michalprusa/DIP/Text/0-0-0-main.tex

% -*- Mode:TeX -*-

%% IMPORTANT: The official thesis specifications are available at:
%%            http://libraries.mit.edu/archives/thesis-specs/
%%
%%            Please verify your thesis' formatting and copyright
%%            assignment before submission.  If you notice any
%%            discrepancies between these templates and the 
%%            MIT Libraries' specs, please let us know
%%            by e-mailing thesis@mit.edu

%% The documentclass options along with the pagestyle can be used to generate
%% a technical report, a draft copy, or a regular thesis.  You may need to
%% re-specify the pagestyle after you \include  cover.tex.  For more
%% information, see the first few lines of mitthesis.cls. 

%\documentclass[12pt,vi,twoside]{mitthesis}
%%
%%  If you want your thesis copyright to you instead of MIT, use the
%%  ``vi'' option, as above.
%%
%\documentclass[12pt,twoside,leftblank]{mitthesis}
%%
%% If you want blank pages before new chapters to be labelled ``This
%% Page Intentionally Left Blank'', use the ``leftblank'' option, as
%% above. 

\documentclass[11pt,oneside]{mitthesis}
\usepackage{lgrind}
\usepackage{titlesec}
\usepackage{pgfplots}
\usepackage{listings}
\usepackage{pdfpages}
\lstset{language=C}
\usepackage{nomencl}
\usepackage{siunitx}

\usepackage{float}

\usepackage[europeanresistors]{circuitikz}

\usepackage{tikz}
%% These have been added at the request of the MIT Libraries, because
%% some PDF conversions mess up the l50\,$\mu$migatures.  -LB, 1/22/2014
\usepackage{cmap}
\usepackage[T1]{fontenc}
\usepackage[utf8]{inputenc}
\pgfplotsset{every axis legend/.append style={
at={(1.1,0.2)},
anchor=south west}} 

\pagestyle{plain}
\titlespacing\section{0pt}{12pt plus 4pt minus 2pt}{12pt plus 4pt minus 8pt}
\renewcommand{\chaptername}{Kapitola}
\renewcommand{\figurename}{Obrázek}
\renewcommand{\tablename}{Tabulka}
\renewcommand{\contentsname}{Obsah}
\renewcommand{\contentsname}{Obsah}
\renewcommand{\listtablename}{Tabulky}
\renewcommand{\listfigurename}{Obrázky}
\renewcommand\bibname{Reference}

%\addtocontents{toc}{\protect\thispagestyle{empty}}
%\addtocontents{lof}{\protect\thispagestyle{empty}}

\newcommand{\itab}[1]{\hspace{0em}\rlap{#1}}
\newcommand{\tab}[1]{\hspace{.2\textwidth}\rlap{#1}}

\newcommand\uv[1]{\quotedblbase #1\textquotedblleft}
\usepgfplotslibrary{polar}
\makenomenclature

\begin{document}

\include{cover}

\pagestyle{plain}
\include{contents}

\setcounter{page}{1}
\include{0-Introduction}
\include{1-Theoretical}
\include{2-Design}
\include{3-Realization}
\include{4-Conclusion}

\include{80-bibl}
\include{0-nome}
%\include{99-add-safety}
\include{99-CD}

\thispagestyle{empty}
\null\newpage

%%\include{biblio}
\end{document}
