michalprusa/DIP/Text/80-bibl.tex

\begin{thebibliography}{9}

\bibitem{ModernLens}
  John Thornton,
  Kao-Cheng Huang,
  MODERN LENS ANTENNAS FOR COMMUNICATIONS ENGINEERING,
  Wiley,
  IEEE PRESS,
  2013.

\bibitem{Dolecek}
  Josef Doleček,
  Fillamentum,
  Parzlich s.r.o.,
  Konzultace na téma výroby filamentů,
  2016.

\bibitem{ConstantineTheory}
  Constantine A. Balanis,
  Antenna theory analysis and design,
  Wiley,
  4th edition,
  2016.

\bibitem{3Dhubs}
  https://www.3dhubs.com/trends,
  2017.

\bibitem{EMIdata}
  https://www.gme.cz/data/attachments/dsh.749-035.1.pdf,
  Datasheet EMI 35 spray,
  2007.

\bibitem{Electroforming}
  http://www.electroforming.cz/cs/technologie,
  Elektroforming, popis technologie 
  2017.

\end{thebibliography}

\newpage

\listoffigures
