michalprusa/DIP/Rozsahy vlnovych delek a kmitoctu.pdf

# Rozsahy kmitočtů a vlnových délek pro vlnovody

R100

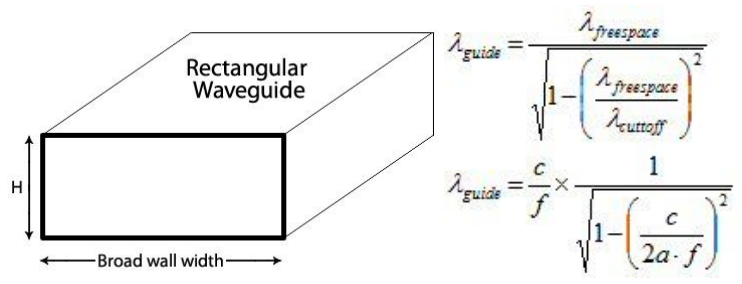
[picture p1: figure]

Dimensions WxH : 22.86 x 10.16 mm

- | Min | Mid | Max
f/GHz | 8.2 | 10.3 | 12.4
ƛ/mm | 60.89 | 37.74 | 28.49

R70

Dimensions WxH : 34.85 x 15.8 mm

- | Min | Mid | Max
f/GHz | 5.85 | 7.025 | 8.2
ƛ/mm | 75.61 | 53.97 | 42.94

R48

Dimensions WxH : 47.55 x 22.15 mm

- | Min | Mid | Max
f/GHz | 3.95 | 4.9 | 5.85
ƛ/mm | 126 | 79.92 | 60.83

//https://www.microwaves101.com/encyclopedias/waveguide-mathematics#guide
