michalprusa/DIP/Text/0-nome.tex

% $Log: abstract.tex,v $
% Revision 1.1  93/05/14  14:56:25  starflt
% Initial revision
% 
% Revision 1.1  90/05/04  10:41:01  lwvanels
% Initial revision
% 
%
%% The text of your abstract and nothing else (other than comments) goes here.
%% It will be single-spaced and the rest of the text that is supposed to go on
%% the abstract page will be generated by the abstractpage environment.  This
%% file should be \input (not \include 'd) from cover.tex.
\thispagestyle{empty}
\chapter*{Seznam použitých symbolů a zkratek}
\thispagestyle{empty}
\itab{3D} \tab{} \tab{3-rozměrné}\\*
\itab{LED} \tab{} \tab{Světlo emitující dioda}\\*
\itab{CD} \tab{} \tab{Kompaktní disk}\\*
\itab{VNA} \tab{} \tab{Vector network analyzer}\\*
\itab{ABS} \tab{} \tab{Acrylonitrile butadiene styrene}\\*
\itab{PLA} \tab{} \tab{Polylactic acid}\\*
\itab{PET} \tab{} \tab{Polyethylene terephthalate}\\*
\itab{D.U.T.} \tab{} \tab{Device under test}\\*
