michalprusa/DIP/Text/1-Theoretical.tex

%% This is an example first chapter.  You should put chapter/appendix that you
%% write into a separate file, and add a line \include{yourfilename} to
%% main.tex, where `yourfilename.tex' is the name of the chapter/appendix file.
%% You can process specific files by typing their names in at the 
%% \files=
%% prompt when you run the file main.tex through LaTeX.
\chapter{Teoretický rozbor}
Před vlastním návrhem a realizací je nezbytně nutné být seznámen alespoň se základní teorií použitých technologií a postupů. Bez této znalosti by se jednalo pouze o útržky textu a nebylo by možno zacházet do řešení komplexnější problematiky a kladení možných dalších témat pro následující výzkum a posun technologie.

\section{3D tisk a materiály}
3D tisk je na rozdíl od jiných technologií aditivní proces. Jedná se tedy o postupné přidávání základního materiálu v diskrétních krocích (vrstvách).
Technologií existuje několik a s postupným rozšiřováním možností aplikace jich stále přibývá. Pro řešení této práce byla vybrána technologie FDM vzhledem k jejímu masovému rozšíření, dostupnosti a nízkých nákladů. 

\subsection{Princip technologie FDM}
Fused deposition modeling, zkráceně FDM, případně FFF (Fused Filament Fabrication) je technologie 3D tisku využívající možnost opakovatelného přechodu mezi skupenstvími působením energie ve formě tepla termoplastických polymerních materiálů. Základní materiál ve formě filamentu (drátu) definovaného průměru, zpravidla 1.75\,mm, nebo 2.85\,mm, je vtlačován do předehřáte trysky silou $F$. Pokud teplota horké zóny trysky převyšuje teplotu skelného přechodu vtlačovaného materiálu dojde k dramatickému oslabení mezimolekulárních sil a vzniku viskózní kapaliny. Jelikož je průměr trysky velmi blízký průměru vtlačovaného filamentu, s výjímkou jejího hrdla které je násobně menší, zpravidla 0.4\,mm, jediná možnost jak uvolnit vnitřní tlak je vytlačení kapaliny hrdlem. Jakmile teplota vytlačené kapaliny klesne pod teplotu skelného přechodu dojde k obnovení mezimolekulárních sil a materiál je opět pevnou látkou. Tento jev je obecně znám pod názvem extruze.
Toto nám však nestačí pro vytvoření trojrozměrného objektu dle zadání. Je tedy třeba extrudér osadit na zařízení zajišťující pohyb v trojrozměrném prostoru.
Proces tisku pak probíhá pohybem extrudéru po předem definovaných trasách, zpravidla vždy v jedné vrstvě, a vytlačováním materiálu dle potřeby. Celý proces se poté opakuje dokud není dokončen zadaný objekt.
\begin{figure}[!htbp!]
\begin{center}
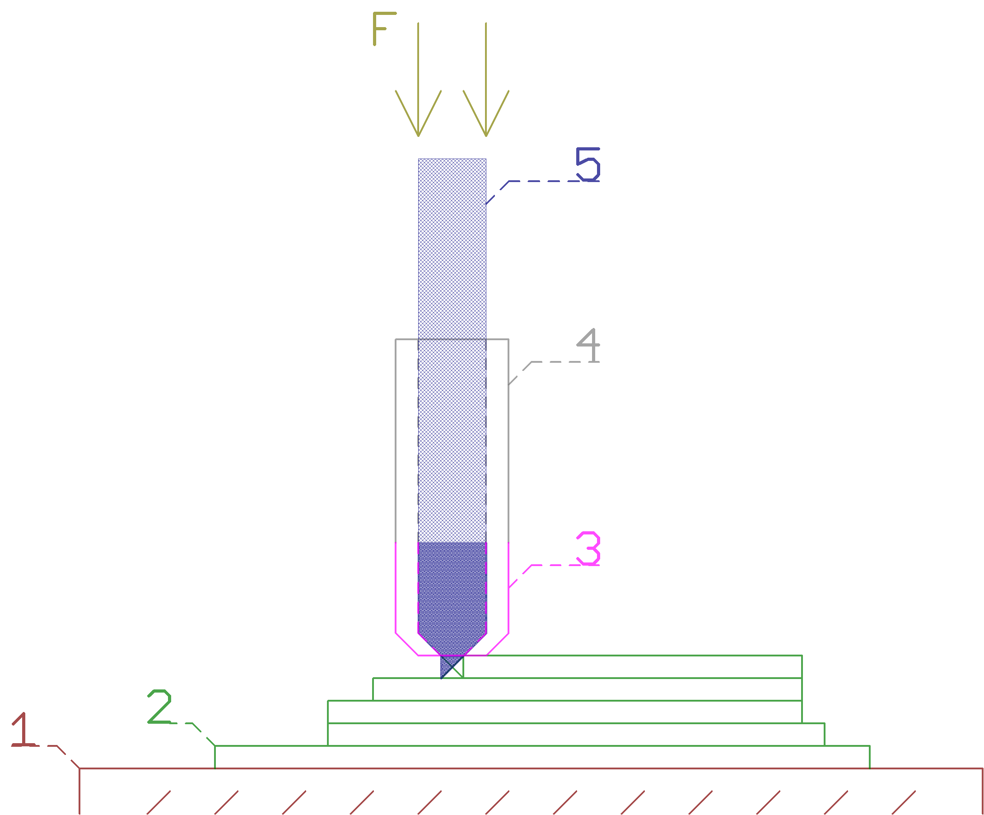
[picture p9: Text/pics/fdm.png]

\caption{Princip technologie FDM. 1 - Tisková podložka, 2 - Již hotové vrstvy výsledného objektu, 3 - Horká zóna trysky, 4 - Tryska, 5 - Filament, F - Vtlačovací síla}
\end{center}
\end{figure}

\subsection{Vlastnosti technologie}
3D tisk, podobně jako jiné technologie má specifické vlastnosti, které ovlivňují charakter výsledného produktu. Ovlivněných vlastností je velmi mnoho, pro naši aplikaci se zaměříme na dielektrické (chceme vědět jaké bude mít výsledný produkt dielektrické vlastnosti, abychom ho byly schopni popsat, navrhovat a simulovat) a mechanické (produkt musí být možno pevně a stabilně ukotvit na pozici, a musí do něj být možno navázat elektromagnetickou vlnu známým způsobem). Je však nutno brát v potaz, že má i celou řadu vlastností, kterých lze využít pro vytvoření složitých struktur, které by nebylo možné jinými technologiemi jednoduše realizovat, například vnitřní uzavřené struktury. Některé z nich jsou zatím pro dostatečně přesné aproximace dosažitelné v reálném časovém horizontu zcela náhodné, jiné zase přímo ovlivňují námi velmi žádané parametry a můžeme je takto řídit.

\subsubsection{Vrstvy}
Pokud budeme uvažovat ideální podmínky (absolutně čisté prostředí bez kontaminace nechtěnými látkami, ideální filament, rovnoměrnou kontrolovanou distribuci tepla, atd...) stále je objekt tvořen z vrstev. Jelikož vždy vrstva, na které se aktuálně nanáší, je dokonce pod teplotou skelného přechodu, pro odstranění deformace vlivem sil jako gravitace, či tepelné roztažnosti, nedojde k dokonalému spojení polymerních řetězců mezi vrstvami. Při laminaci vrstev může také dojít ke kontaminaci produktu, jako například prachovými částicemi či vzduchovými kapsami. Toto se však dá zanedbat jelikož lze snadno stabilizovat okolní prostředí a minimalizovat vliv. 
Hlavní ovlivněné vlastnosti, pro naši aplikaci podstatné, jsou mechanické. Vždy je v ose vrstev rozložení meze plasticity neuniformní, dochází tedy k plastické deformaci významně v těchto oblastech, což někdy může být problém z důvodu nutnosti splnění možnosti upevnění a realizovatelnosti produktu.
Z dielektrického hlediska tedy nebude ani relativní permitivita uniformně rozložená v jedné ose, vznikne tedy periodická struktura. Tento vliv by bylo možné omezit buďto zvýšením diskretizačního kroku, tedy omezením počtu rozhraní, což může v jistých případech ovlivňovat vlastnosti celé struktury vzhledem růstu kvantizačního šumu, nebo naopak snížením kroku kdy již bude úroveň šumu blízká nule, což se bohužel negativně projeví na době tisku, to však v některých případech není problém. Výzkum popisu tohoto chování je však předmětem dalším.

\subsubsection{Vnitřní struktury}
Vlivem principu vrstvení je možno vytvářet vnitřní struktury definovaných tvarů, dokonce i selektivně, a takto velmi silně ovlivňovat pro nás důležité parametry.
Mechanické vlastnosti tímto lze selektivně měnit, například zpevněním montážních otvorů v technologickém okolí, což v našem případě není první v pořadí.
Dielektrické vlastnosti jsou tímto však velmi ovlivněny. Technologií je totiž možno vytvářet prakticky jakékoliv struktury uvnitř produktu ve zvolených místech, tedy například vytisknout Luneburgovu či Maxwell fish-eye čočku. Je však ale nutno provést výzkum na toto téma dostatečné podrobný výzkum, jedná se totiž o skokové změny vlastností. Tyto změny poté vytváří rozhraní, kde dochází odrazům, které zatím modelovat a popsat je velmi komplexní úlohou.

\begin{figure}[!htbp]
\begin{center}
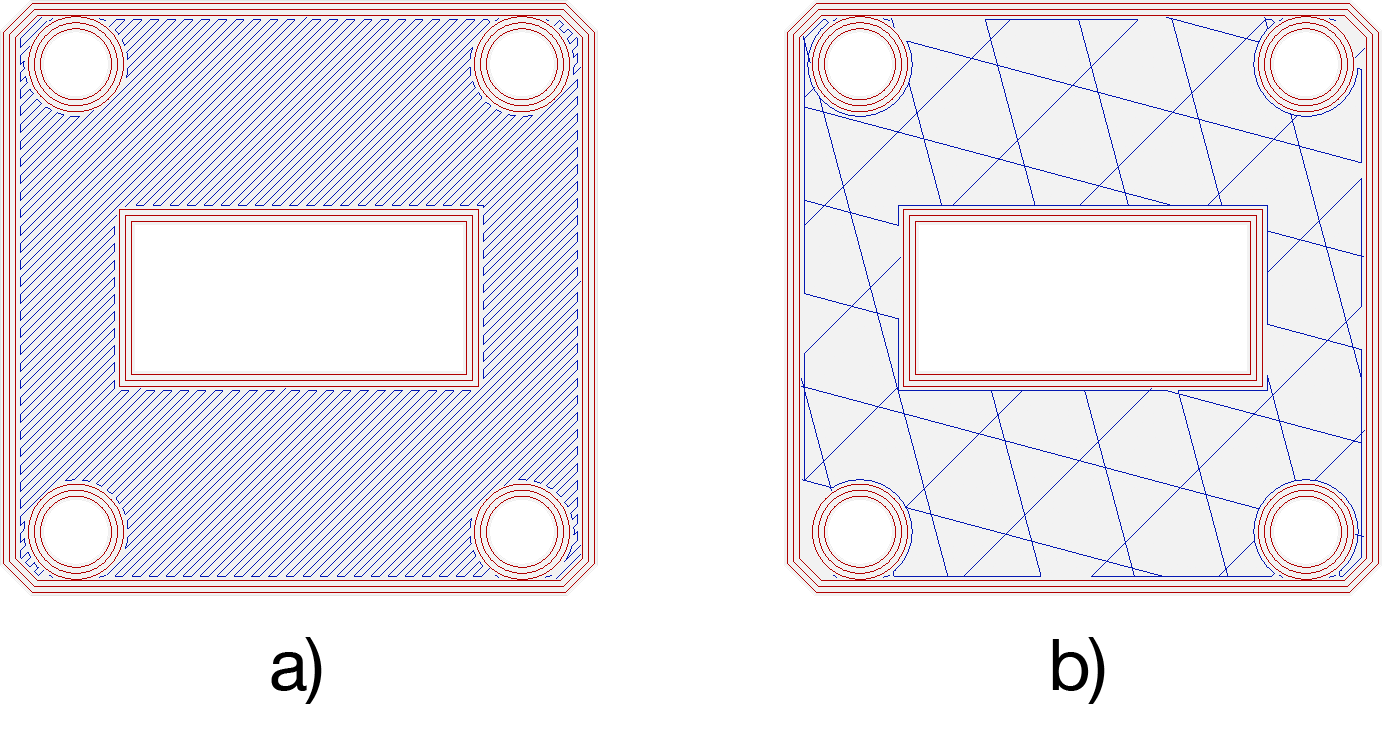
[picture p10: Text/pics/fillcompare.png]

\caption{Porovnání různého motivu vrstvy, a) 100\,\% vyplň typem rectilinear, b) 20\,\% vyplnň typem cubic}
\end{center}
\end{figure}

\begin{figure}[!htbp]
\begin{center}
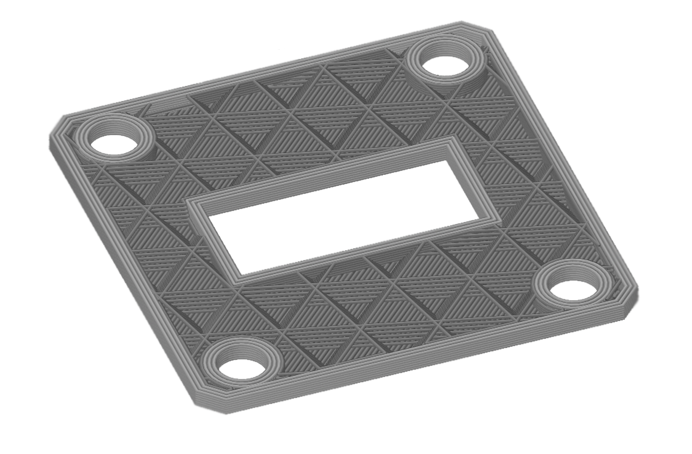
[picture p11: Text/pics/6layer.png]

\caption{Náhled vrstev 1-6 struktury s kombinovanou výplní typu rectilinear (první dvě vrstvy) a cubic o rozdílné procentuální výplni}
\end{center}
\end{figure}

\subsection{Materiály využitelné pro vysokofrekvenční techniku}
Termopolymerních materiálů které by se daly využít je celá řada, teoreticky je možné uplatnit velké množství, prakticky však ale vyplývá otázka bezpečnosti, jelikož průchod některých polymerů procesem může uvolňovat nebezpečné látky, či v případě směsí její části. Dále je však nutné brát v potaz i vlastnosti jako tepelná roztažnost 
Mezi nejrozšířenější patří PLA, ABS a PET, tyto materiály však lze uplatnit zejména v čočkách, či dielektrických rezonátorech, jelikož vykazují velmi malou vodivost. Objevují se ale stále nové směsy materiálů jako například PLA s výraznou příměsí grafénových šupin, či měděného prachu které v ideálním případě disponují velmi vysokou vodivostí.

\subsubsection{"Vodivé" materiály}
Jelikož mezi nejrozšířenější materiály patří PLA, které vykazuje výborné zpracovatelské vlastnosti je většina těchto směsí právě na tomto nosiči.
Jako příměs pro vodivé materiály je možno použít teoreticky jakékoliv fragmenty vodivé látky jako třeba měď, stále populárnější je ale grafén, z důvodu jeho vysoké vodivosti způsobené $\pi$ elektrony. Při plnění nosného polymeru je však nutno brát v potaz že při zvyšujícím se podílu plniva se vlastnosti výsledné směsi velmi mění.
Jelikož je pro nás nyní nejvýznamnější elektrická vodivost, je tedy logický cíl maximalizace právě tohoto kritéria. Bohužel se ale stále bude jednat o směs vysoce vodivého materiálu ve velmi nevodivém polymeru, což má dramatický dopad na výsledek. V první řadě ikdyž budeme uvažovat dokonale uniformní rozložení a identické frakce příměsi ve filamentu, vlivem průchodu extrudérem nelze předpokládat, že výsledek bude stejný. Dochází totiž k opětovnému promísení a dokonalý popis celého systému zatím není znám. V druhé řadě je třeba stále brát ohled na zpracovatelnost materiálu a volit správné poměry příměsí, z pravidla 40 - 80\,\%\cite{Dolecek}. Z výše uvedených faktů je bohužel patrné, že výsledný produkt má nezanedbatelné dielektrické vlastnosti.
Ačkoliv se může zdát že tyto materiály nejsou pro naši aplikaci zatím použitelné, stále existuje možnost následného pokovení produktu, kde tyto vlastnosti výrazně zjednoduší proces.

\section{Trychtýřová anténa}
Trychtýřová anténa patří mezi základní anténní struktury využívané jak samostatně, tak ve formě ozařovačů reflektorových antén, či v kombinaci s anténní čočkou. Těchto struktur existuje několik druhů, v našem případě se ale zaměříme na nejpoužívanější, tedy pyramidální trychtýřovou anténu.
Tento typ antény byl zvolen zejména kvůli své jednoduchosti a požadavkům na technologii výroby.

\subsection{Základní princip}
Trychtýřová anténa není nic jiného, než postupně se rozšiřující ústí vlnovodu v daných směrech. Postupné otevření trychtýře lze považovat za impedanční transformátor zajišťující, v ideálním případě bezodrazné, vyvázání vlny do volného prostoru v definovaném pásmu \ref{fig:hornPrinciple}.

\begin{figure}[!htbp]
\begin{center}
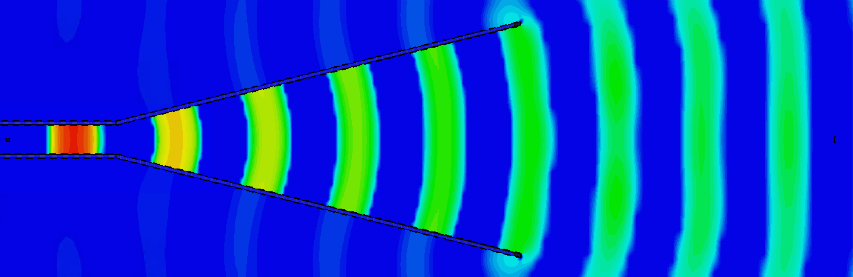
[picture p12: Text/pics/HornPrinciple.png]

\caption{Princip trychtýřové antény}
\label{fig:hornPrinciple}
\end{center}
\end{figure}

Na základě roviny, ve kterém dochází k otevření vlnovodu je lze rozdělit do následujících základních kategorií:
\begin{itemize}
\item E-rovinné (v rovině E)
\item H-rovinné (v rovině H)
\item Pyramidální (v obou rovinách)
\item Kónické ( speciální případ rozšiřujícího-se kruhového vlnovodu)
\end{itemize}

\begin{figure}[!htbp]
\begin{center}
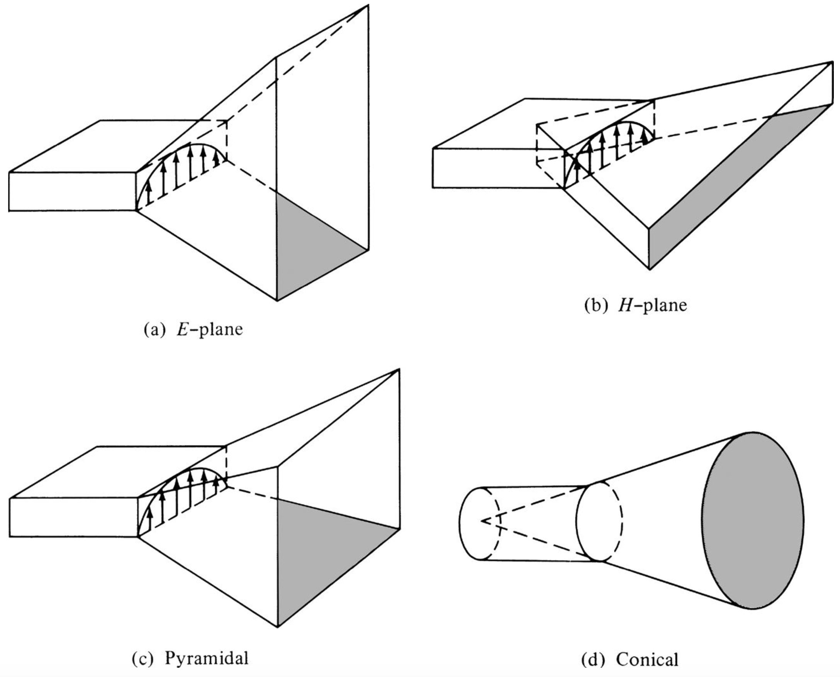
[picture p13: Text/pics/HornTypes.png]

\caption{Typické provedení trychtýřových antén \cite{ConstantineTheory}}
\label{fig:horn}
\end{center}
\end{figure}

Každá kategorie má své specifické vlastnosti, například z hlediska směrových charakteristik. Pokud dojde k otevření pouze v rovině H, dojde k významnému potlačení postranních laloků a zároveň snížení šířky svazku v porovnání se směrem otevření pouze v rovině E \ref{fig:hornComp}.

\begin{figure}[!htbp]
\begin{center}
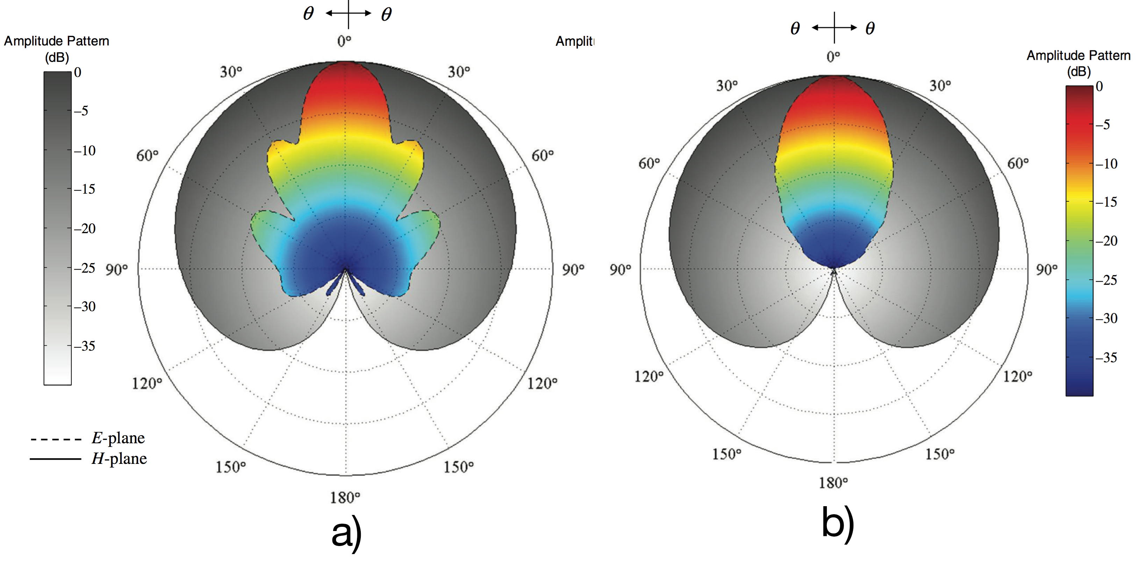
[picture p14: Text/pics/hornComp.png]

\caption{Porovnání směrových charakteristik trychtýřové antény s otevřením v rovině a) E , b) H \cite{ConstantineTheory}}
\label{fig:hornComp}
\end{center}
\end{figure}

\subsubsection{Pyramidální trychtýřová anténa}
Jedná se o nejrozšířenější typ trychtýřové antény, u které, jak již víme, dochází k otevření v obou rovinách. Výsledná vyzařovací charakteristika je pak kombinací E-trychtýře a H-trychtýře, kde dojde v ideálním případě ke shodě v obou rovinách. Není však ale pravidlo, aby se maximum směrovosti nacházelo v ose antény jako v předchozích případech.

Základní parametry jsou vyobrazeny na obrázku \ref{fig:horn},\ref{fig:hornEH}.

\begin{figure}[!htbp]
\begin{center}
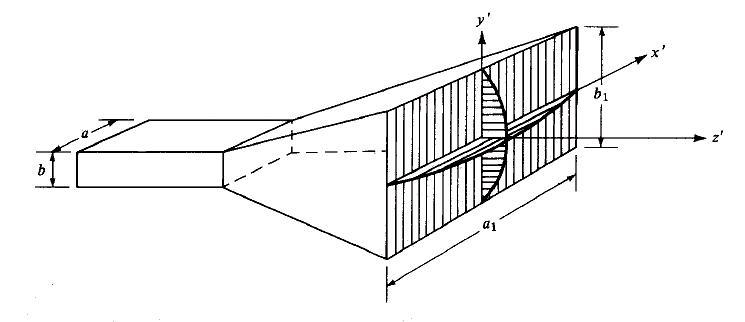
[picture p15: Text/pics/horn.png]

\caption{Pyramidální trychtýřová anténa \cite{ConstantineTheory}}
\label{fig:horn}
\end{center}
\end{figure}

\begin{figure}[!htbp]
\begin{center}
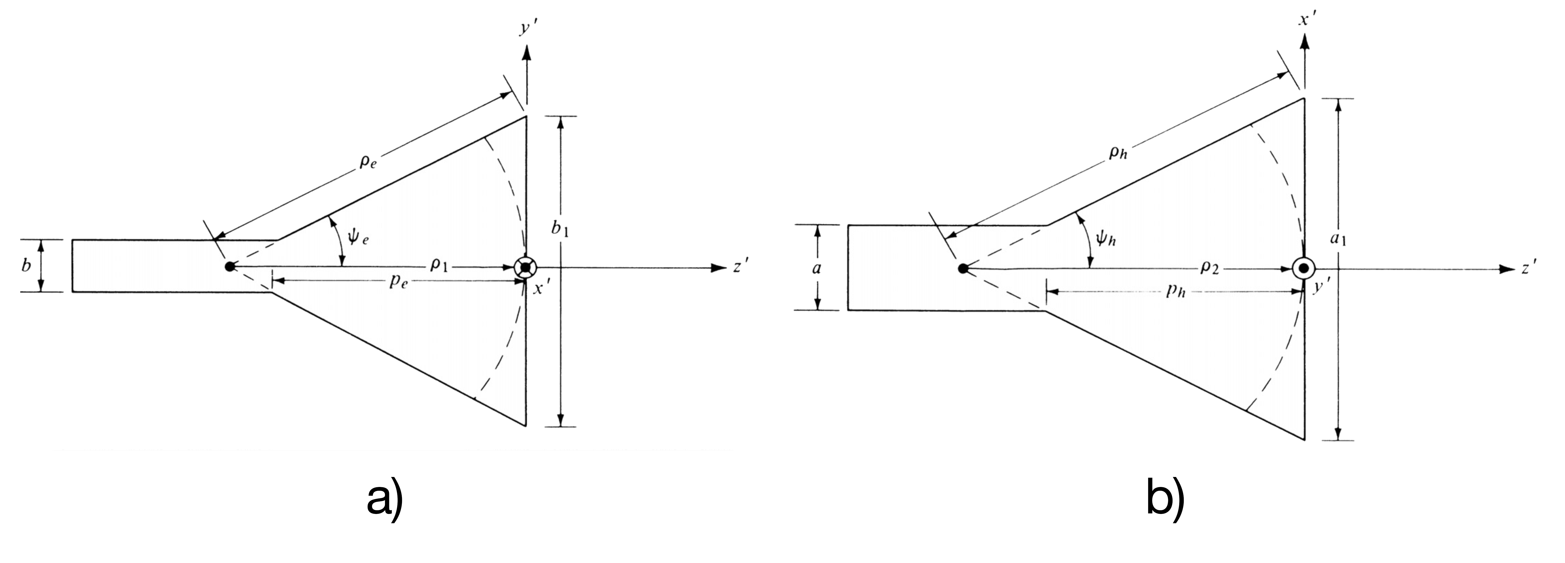
[picture p16: Text/pics/hornEH.png]

\caption{Pyramidální trychtýřová anténa v řezu a)E-roviny, b)H-roviny \cite{ConstantineTheory}}
\label{fig:hornEH}
\end{center}
\end{figure}
\begin{itemize}
\item $a, b$ - Rozměry vlnovodu
\item $a_1, b_1$ - Rozměry ústí trychtýře
\item $p_1, p_2$ - Vzdálenost vrcholu trychtýře od ústí v E a H rovině
\item $x', y'$ - E-rovina, H-rovina
\item $z'$ - Směr Poyntingova vektoru
\item $\rho$ - Délka stěny trychtýře
\item $p$ - Délka trychtýře
\item $\psi$ - Úhel otevření
\end{itemize}

\subsection{Elektrické parametry}

\subsubsection{Vstupní impedance}
Důležitým parametrem každé antény je její vstupní impedance, která nám určuje, jakou charakteristickou impedanci by mělo mít napájecí vedení, případně jaký je nutno navrhnout přizpůsobovací obvod. Hlavním cílem při následné aplikaci struktury je minimalizovat ztráty nepřizpůsobením a tím maximalizovat vyzářený výkon.

\subsubsection{Směrovost a zisk}
Směrovost charakterizuje strukturu z hlediska poměru intenzit vyzářeného výkonu struktury do určitého směru, ku celkovému vyzářenému výkonu do celého prostoru. Jde tedy o schopnost antény "směrovat" výkon do určitého směru. Toto však z principu reciprocity platí i opačně, tedy pro přijatý výkon. Na základě tohoto lze definovat maximální směrovost antény \ref{eq:hornD}.

\begin{equation}
D_p = 10 [1.008+\log_{10}({\frac{a_1  b_1}{\lambda^2}})] ; [dB, m, m, m]
\label{eq:hornD}
\end{equation}

\renewcommand{\figurename}{Obrázek}
Zisk antény \ref{eq:hornG} je však pro aplikace zajímavějším parametrem, jelikož zahrnuje i ztráty vyzařovací účinností $\eta_r$.
\begin{equation}
G = D - \eta_{r} ; [dB, dB , dB]
\label{eq:hornG}
\end{equation}

\subsubsection{Fázová chyba}
Jelikož při vyvazování vlny z vlnovodu do volného prostředí dochází k transformaci vlny rovinné na kulovou. Z této skutečnosti plyne, že na rozhraní ústí trychtýře bude existovat oblast, kde se střed vlny bude nacházet právě na rozhraní, ale její okraje stále uvnitř. Tento rozdíl se nazývá fázová chyba a vede k deformaci směrové charakteristiky a snížení směrovosti, viz obrázek \ref{fig:HornLenDep}. Pro minimalizaci této chyby je vhodné, aby úhel otevření trychtýře byl co nejmenší, nicméně je však ale nutno brát v potaz, že tímto narůstá jeho délka a zároveň i náročnost realizace.
\begin{figure}[!htbp]
\begin{center}
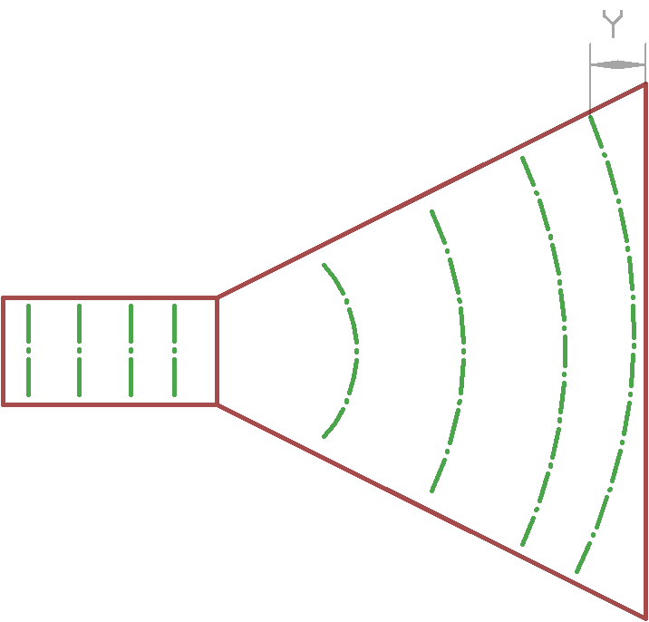
[picture p17: Text/pics/hornErr.png]

\caption{Znázornění fázové chyby $Y$}
\label{fig:HornErr}
\end{center}
\end{figure}

\begin{figure}[!htbp]
\begin{tikzpicture}[scale=1.4]
\begin{axis}[
    xlabel={Angle /},
    ylabel={Amplitude /\,dB},
    minor tick num=10,
    minor grid style={gray!25},
  	major grid style={black!50},
  	xmin=-180,xmax = 180,
  	%ymin=-120, ymax=-60,
    grid=both
]
\addplot [no markers, thick, blue] table [col sep=tab, y=AeOpt] {hornSim.dat};
\addplot [no markers, thick, green] table [col sep=tab, y=Ae180] {hornSim.dat};
\addplot [no markers, thick, orange] table [col sep=tab, y=Ae140thin] {hornSim.dat};
\legend{228\,mm,180\,mm,140\,mm};
\end{axis}
\end{tikzpicture}
\caption{Řezy směrových charakteristiky v E rovině pro různé délky pyramidálního trychtýře při zachování rozměrů apertury (CST MW studio simulace)}
\label{fig:HornLenDep}
\end{figure}

\newpage
\section{Anténní čočky}
Podobně jako v optice, i zde lze použít čočku, jelikož světlo má z důvodu duality i charakter vlny.
Oblasti použití anténních čoček se velmi podobají například parabolickým reflektorům, kde počátek pásma použitelnost se pohybuje kolem 1\,GHz a ideální použití od 3\,GHZ a výše. Samozřejmě že jde aplikovat čočky i při použití nižších pásem, ale je nutno brát v potaz, že na nižších kmitočtech narůstá jejich velikost a hmotnost. 

Existuje tedy celá řada různých realizací čoček, v anténní doméně je lze rozdělit do dvou základních kategorií:
\begin{itemize}
\item Zpomalovací, neboli dielektrické
\item Urychlující, neboli kovové
\end{itemize}

\subsection{Základní princip}
Hlavním úkolem čočky je kolimovat paprsek, neboli snížit rozbíhavost, neboli transformovat kulovou vlnu na rovinnou. Jak můžeme vidět na obrázku \ref{fig:hornLens}, kde:
\begin{itemize}
\item $1$ - Trychtýřová anténa
\item $2$ - Vystupující kulová vlna z trychtýře
\item $3$ - Anténní plano-konvexní čočka
\item $4$ - Výsledná rovinná vlna
\item $X$ - Parametr kulovitosti vstupní vlny
\item $X'$ - Parametr kulovitosti výstupní vlny
\end{itemize}
\begin{figure}[!htbp]
\begin{center}
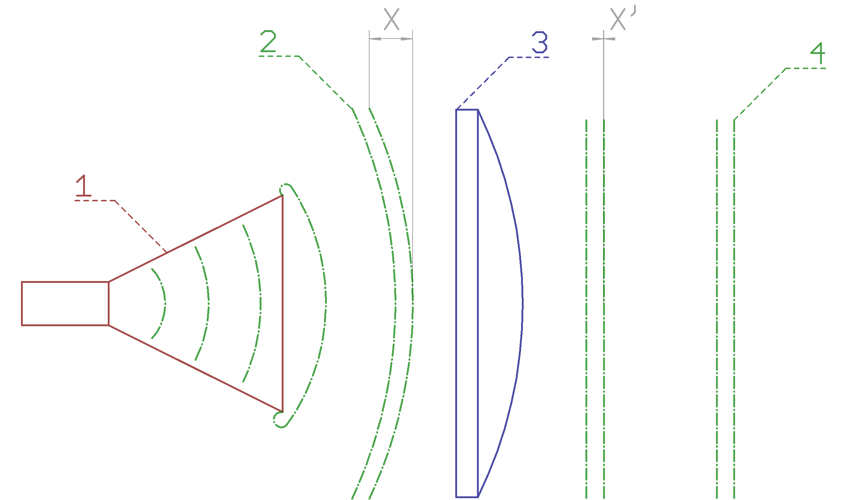
[picture p18: Text/pics/lens.png]

\caption{Princip anténní čočky}
\label{fig:hornLens}
\end{center}
\end{figure}

\subsection{Charakterizace struktury}

\subsubsection{Permitivita}
Opět analogií k optickému pohledu na problematiku, kde je hlavním charakterizačním parametrem index lomu, který určuje rychlost šíření vlny v materiálu, ze kterého je čočka vytvořena, je zde nahrazena relativní permitivitou prostředí. Pro zajištění této funkce je však ale nutno, aby anténní čočka měla rozdílnou relativní permitivitu $\epsilon_r$ než okolní prostředí, ve kterém se vlna šíří. Touto podmínkou je způsobeno zpomalení, nebo zrychlení, vlny a následna kolimace. Z čehož plyne již výše uvedené rozdělení čoček, viz obrázek \ref{fig:LensTypes}.

\subsubsection{Ohnisková vzdálenost}
Dalším nutným parametrem pro splnění kolimace vlny je ohnisková vzdálenost. Tento parametr určuje, v jaké vzdálenosti musí být zdroj kulové vlny, aby došlo k úplné korekci fázové chyby, tedy kolimace.

\begin{figure}[!htbp]
\begin{center}
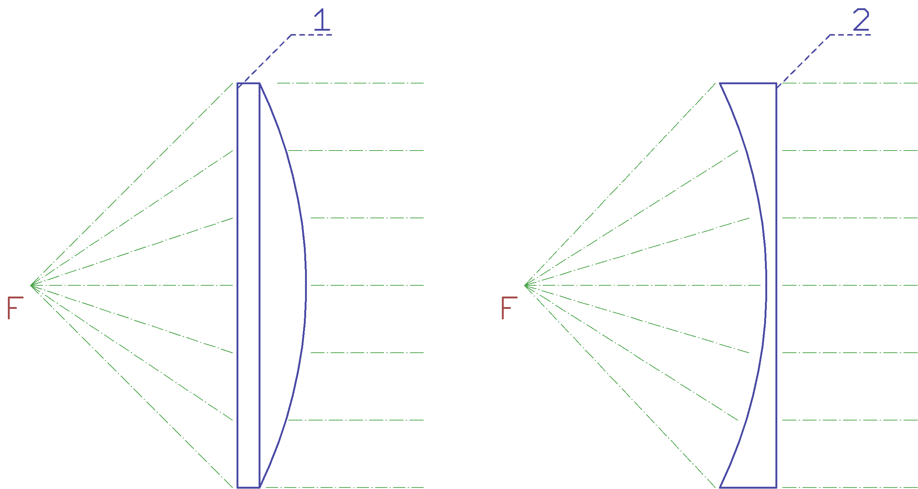
[picture p19: Text/pics/lenstypes.png]

\caption{Typy anténních čoček. 1 - Zpomalující, 2 - Zrychlující}
\label{fig:LensTypes}
\end{center}
\end{figure}

\section{Extrakce dielektrických parametrů}
Znalost dielektrických parametrů je klíčová pro návrh vlastních struktur, zejména anténních čoček.
Pro většinu materiálů jsou tyto parametry již známé, nicméně pokud se rozhodneme strukturu realizovat technologií 3D tisků, vstupuje do tohoto mnoho dalších proměnných které mohou výrazně ovlivnit výsledné parametry produktu, ať už v prospěch, či naopak.

Mezi základní metody extrakce patří:
\begin{itemize}
\item Reflexní
\item Transmisní/reflexní
\item Rezonanční
\item Planárních obvodů
\end{itemize}
Reflexní metoda je založena na principu odrazů na diskontinuitách impedance vedení při přítomnosti neznámého vzorku.
Rezonanční metody naopak extrahuje parametry na základě charakteristických vlastností vzorku v rezonátoru.
Transmisní/reflexní metody charakterizují materiál znalosti vzniklých odrazů a transmisí při vložení do vedení .
Metody planárních obvodů poté využívají stejných principů aplikovaných na planárních mikrovlnných obvodech.
