michalprusa/DIP/Text/0-aff.tex

% $Log: abstract.tex,v $
% Revision 1.1  93/05/14  14:56:25  starflt
% Initial revision
% 
% Revision 1.1  90/05/04  10:41:01  lwvanels
% Initial revision
% 
%
%% The text of your abstract and nothing else (other than comments) goes here.
%% It will be single-spaced and the rest of the text that is supposed to go on
%% the abstract page will be generated by the abstractpage environment.  This
%% file should be \input (not \include 'd) from cover.tex.
Prohlašuji, že jsem zadanou bakalářskou práci „Trychtýřová anténa s dielektrickou čočkou realizovaná technologií 3D tisku“ zpracoval sám s přispěním vedoucího práce a používal jsem pouze literaturu uvedenou na konci práce. Souhlasím se zapůjčováním práce a jejím zveřejňováním.
\vspace{2cm}

\noindent V Praze dne 18.5.2017 \hfill Michal Průša
