michalprusa/DIP/Ant/LengthDependency/108mm/FarField.png

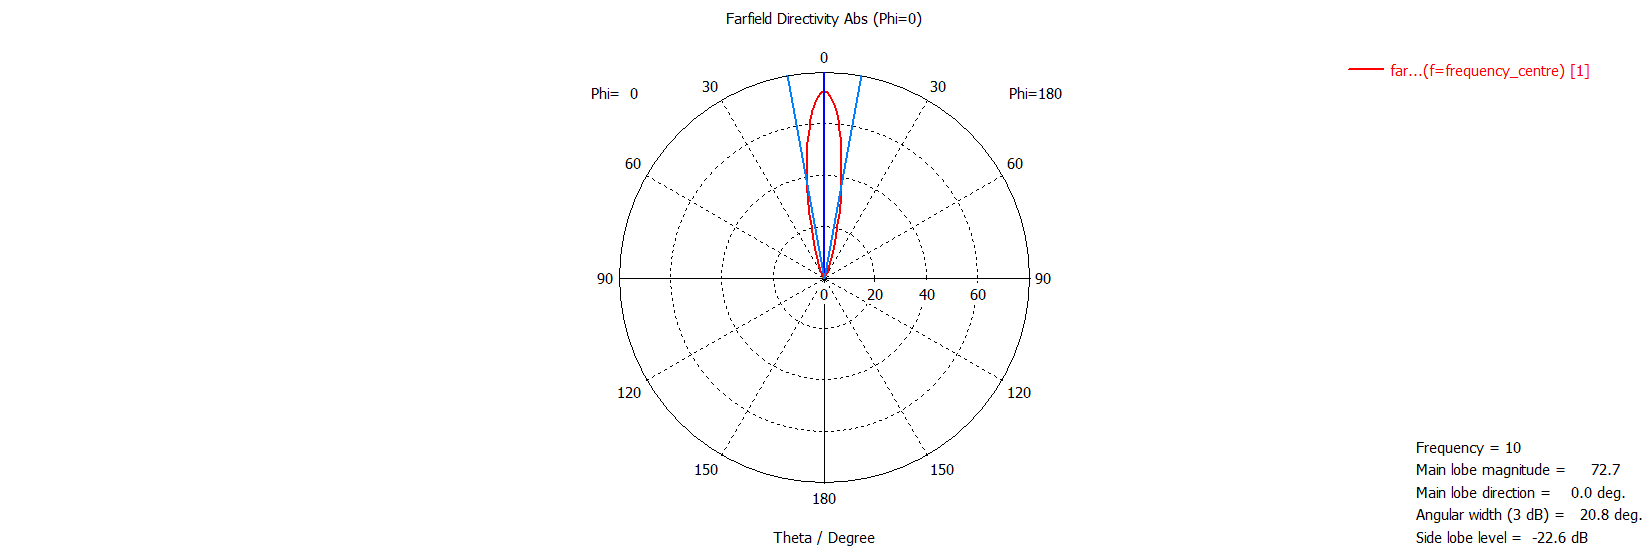
Ant/LengthDependency/108mm/FarField.png
