michalprusa/DIP/Text/pics/14layer.png

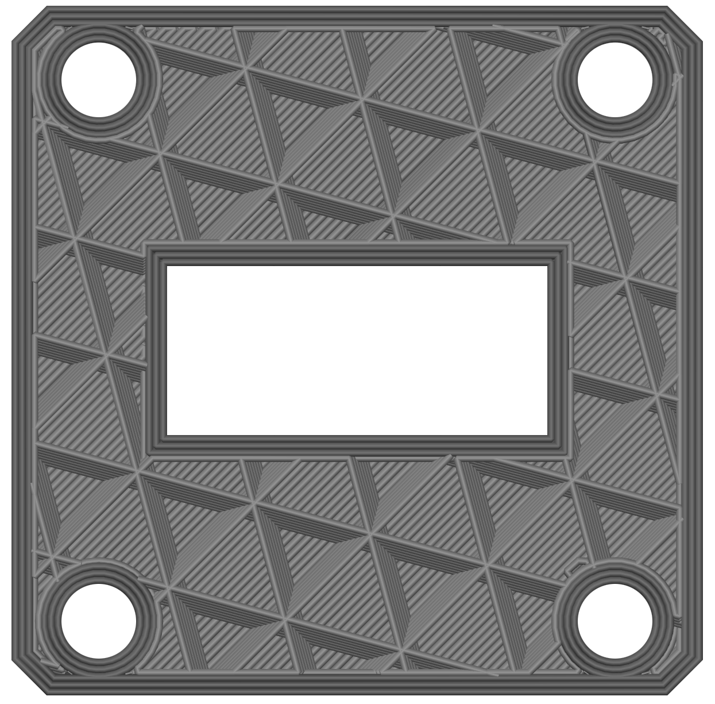
Text/pics/14layer.png
