michalprusa/DIP/Text/pics/FillLayer.png

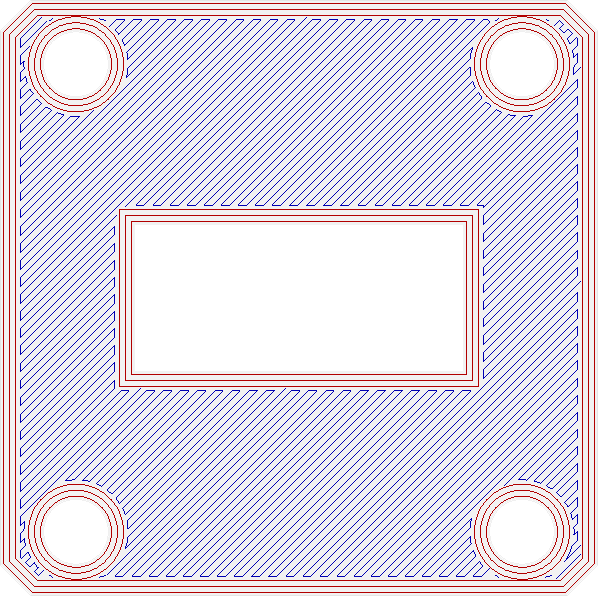
Text/pics/FillLayer.png
