michalprusa/DIP/Text/pics/final/IMG_8202.JPG

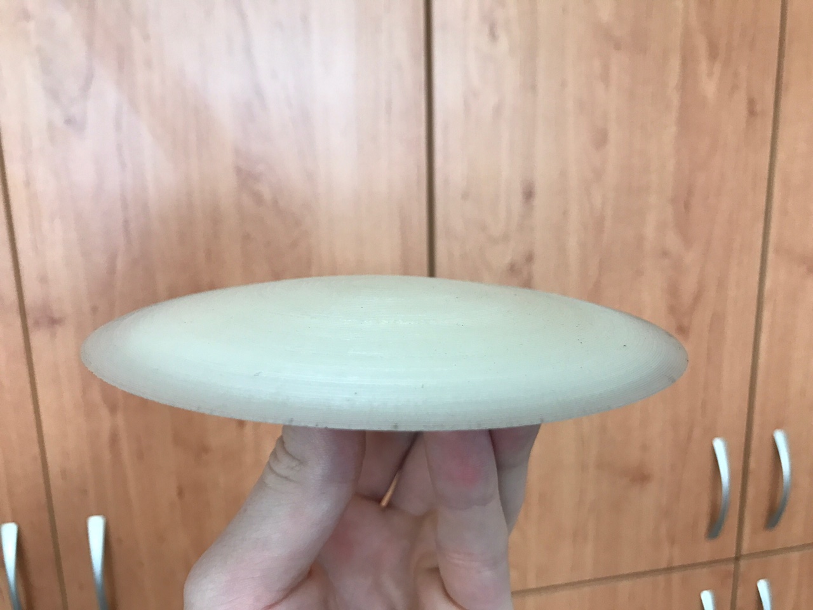
Text/pics/final/IMG_8202.JPG
