michalprusa/DIP/Text/pics/hornD.png

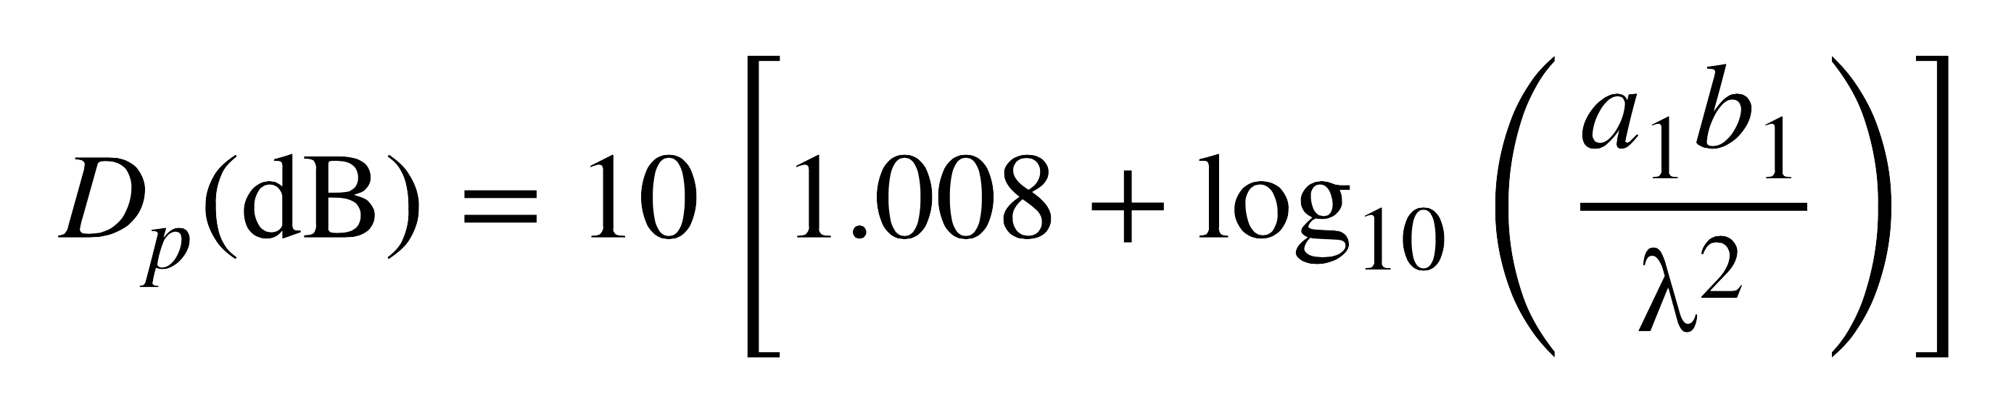
Text/pics/hornD.png
