michalprusa/DIP/Text/pics/InfillLayer.png

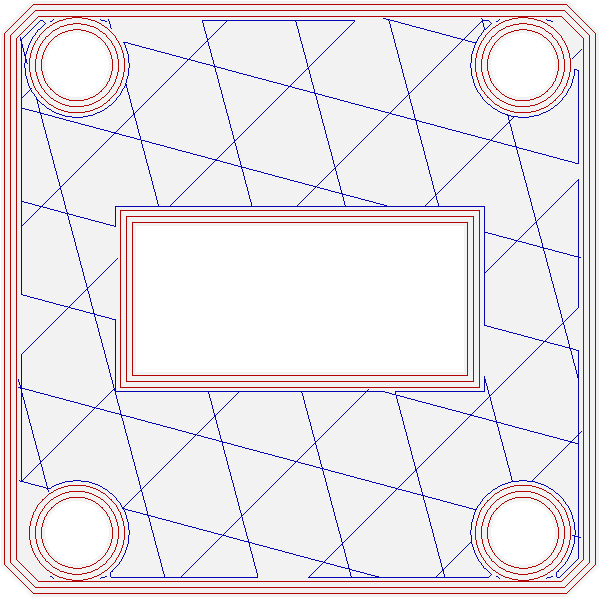
Text/pics/InfillLayer.png
