michalprusa/DIP/Text/pics/plated/IMG_8190.JPG

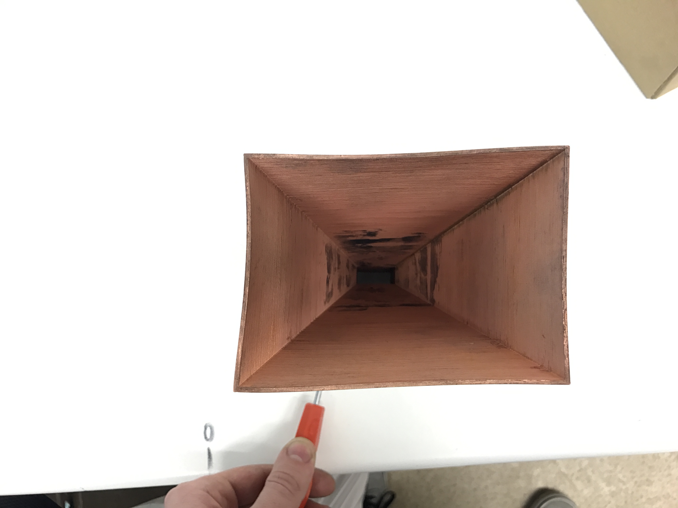
Text/pics/plated/IMG_8190.JPG
