michalprusa/DIP/Text/pics/plated/IMG_8191.JPG

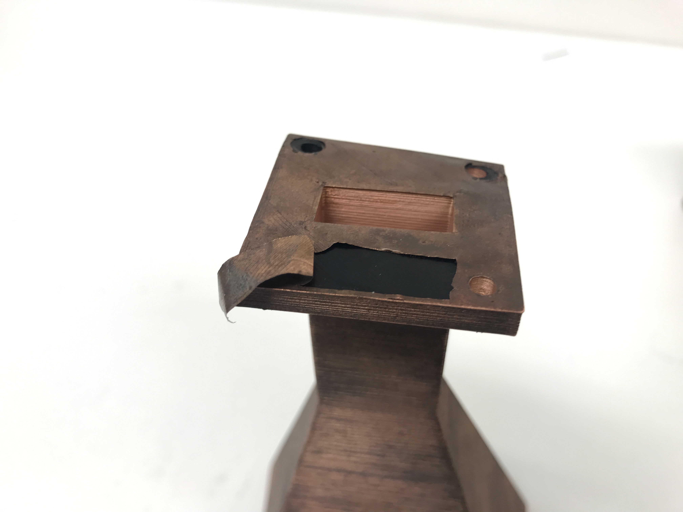
Text/pics/plated/IMG_8191.JPG
