michalprusa/DIP/Text/pics/plated/IMG_8192.JPG

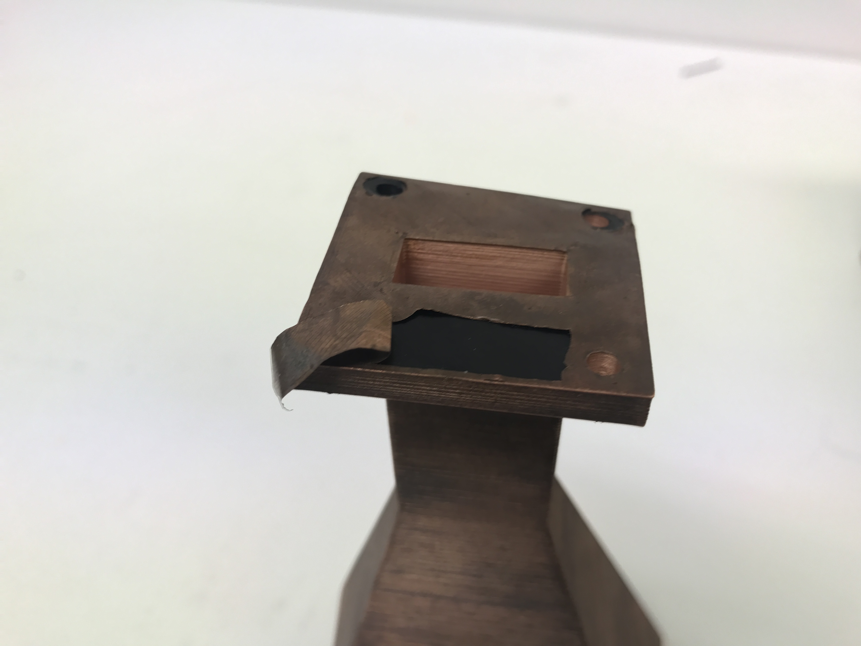
Text/pics/plated/IMG_8192.JPG
