michalprusa/DIP/Ant/Horn10G-140mm.stl

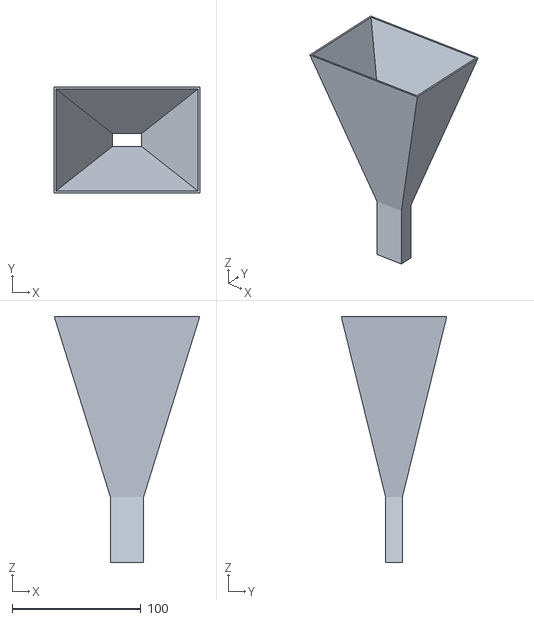
[picture p39: CAD file, 2017-04-09]
Ant/Horn10G-140mm.stl
113.0 x 82.0 x 191.0
