michalprusa/DIP/Ant/hrn2part/hornadapter.stl

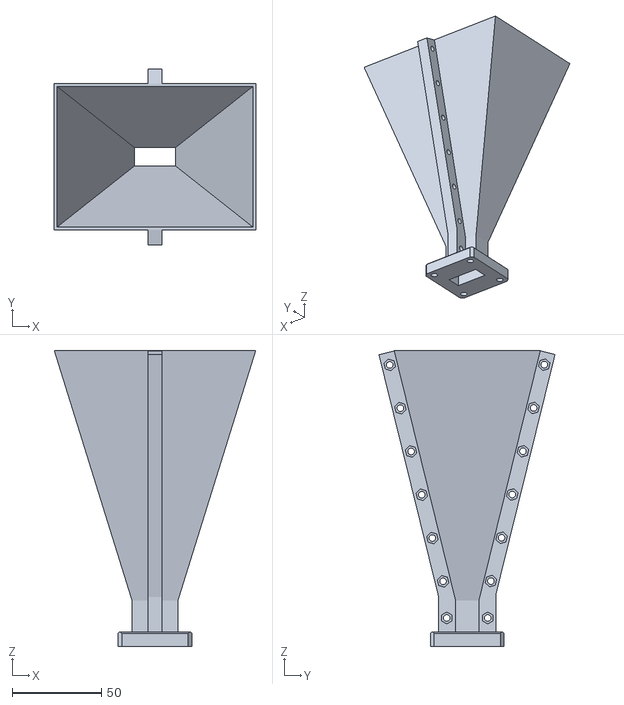
[picture p40: CAD file, 2017-05-14]
Ant/hrn2part/hornadapter.stl
113.0 x 98.8 x 166.0
