michalprusa/DIP/Lens/horn.stl

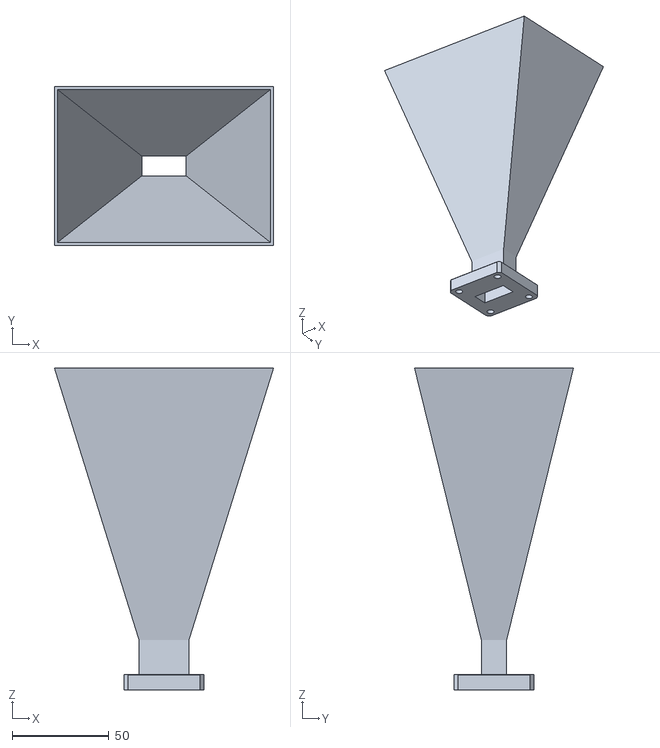
[picture p41: CAD file, 2017-05-25]
Lens/horn.stl
113.0 x 82.0 x 166.0
