michalprusa/DIP/models/waveguide-plug/waveguide-plug-R100-L5-XY0-Z0-C1.stl

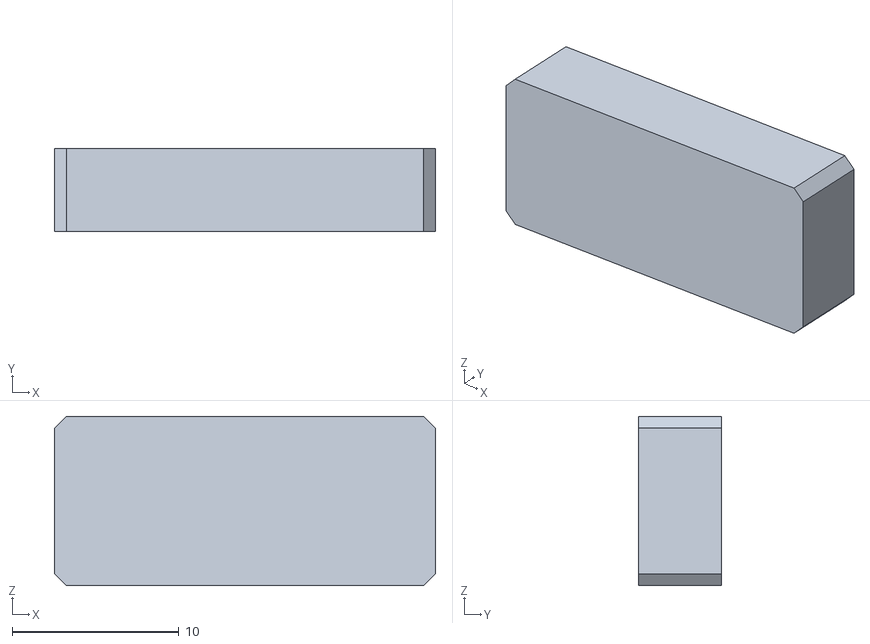
[picture p42: CAD file, 2017-04-02]
models/waveguide-plug/waveguide-plug-R100-L5-XY0-Z0-C1.stl
22.9 x 5.00 x 10.2
