michalprusa/DIP/Text/pics/hornik.dxf

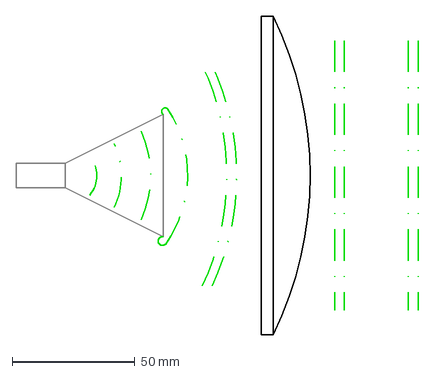
[picture p43: CAD file, 2017-05-23]
Text/pics/hornik.dxf
164.0 x 130.0 mm
