michalprusa/DIP/Ant/hrn2part/hornadapterRp.stl

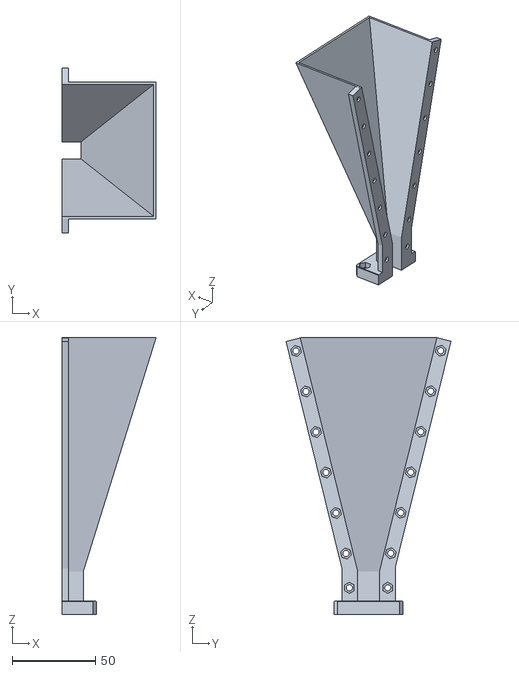
[picture p44: CAD file, 2017-05-14]
Ant/hrn2part/hornadapterRp.stl
56.5 x 98.9 x 166.0
