michalprusa/DIP/D/man-data/hrn.stl

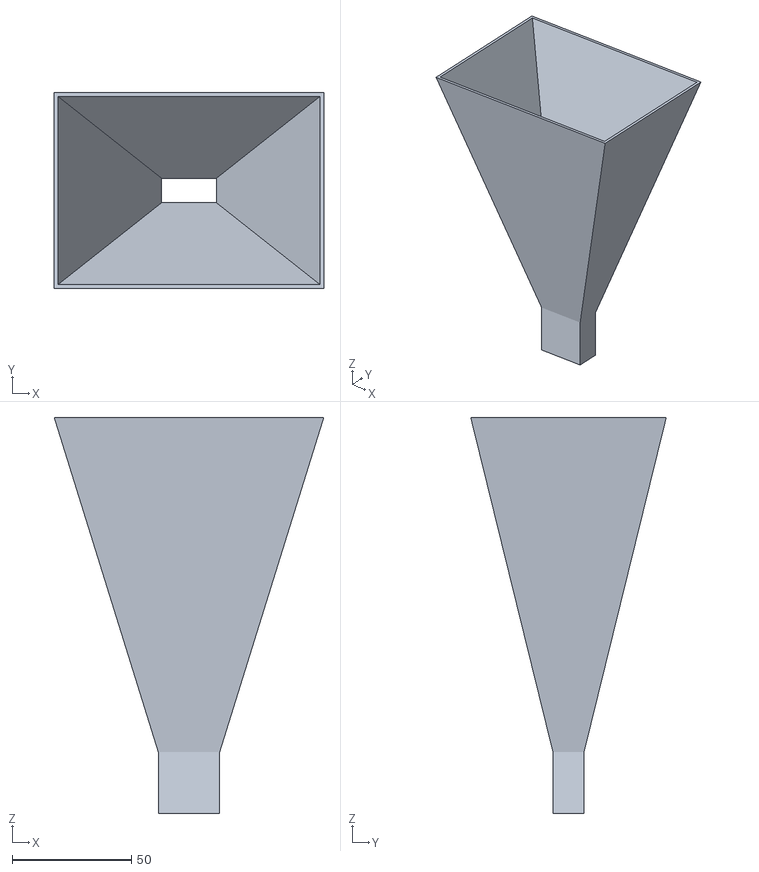
[picture p45: CAD file, 2017-05-14]
D/man-data/hrn.stl
113.0 x 82.0 x 166.0
