michalprusa/DIP/Lens/lens.dxf

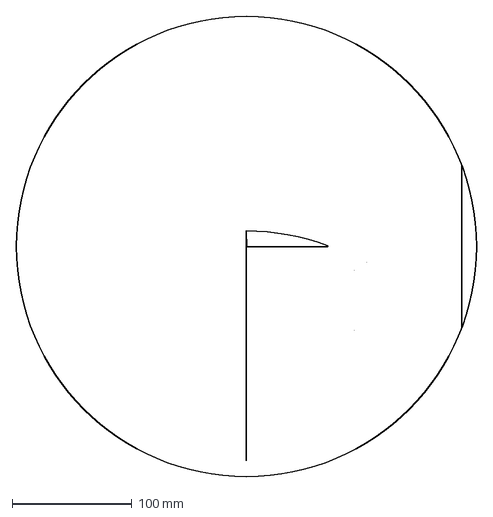
[picture p46: CAD file, 2017-05-10]
Lens/lens.dxf
384.0 x 384.0 mm
