michalprusa/DIP/D/man-data/Horn10G-140mm+adapt5.stl

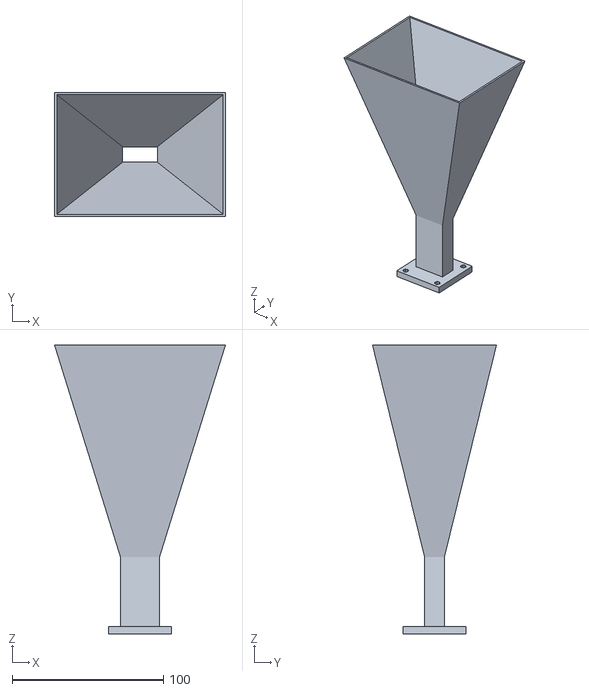
[picture p48: CAD file, 2017-05-10]
D/man-data/Horn10G-140mm+adapt5.stl
113.0 x 82.0 x 191.0
