michalprusa/DIP/models/waveguide-plug/waveguide-plug-R100-L10-XY0-Z0-C1.stl

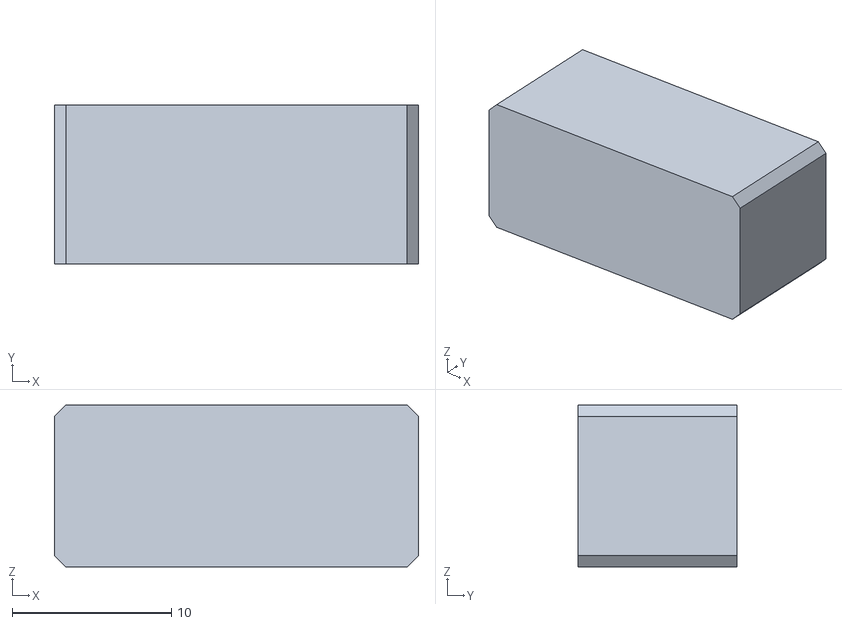
[picture p49: CAD file, 2017-04-02]
models/waveguide-plug/waveguide-plug-R100-L10-XY0-Z0-C1.stl
22.9 x 10.0 x 10.2
