michalprusa/DIP/D/man-data/lens.stl

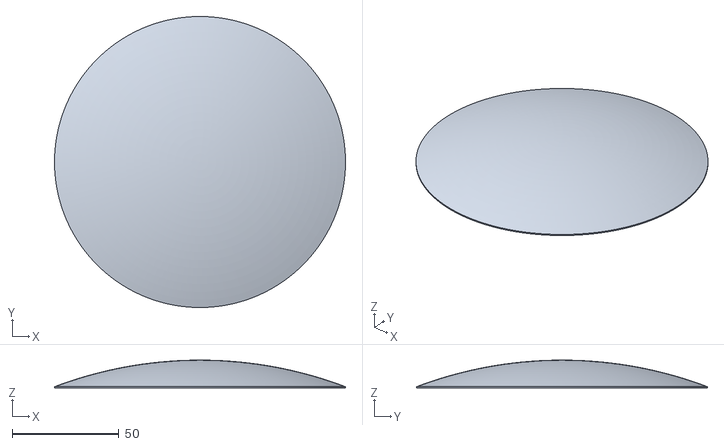
[picture p50: CAD file, 2017-05-10]
D/man-data/lens.stl
136.0 x 136.0 x 13.0
