michalprusa/DIP/models/waveguide-plug/waveguide-plug-R100-L49-XY0-Z0-C1.stl

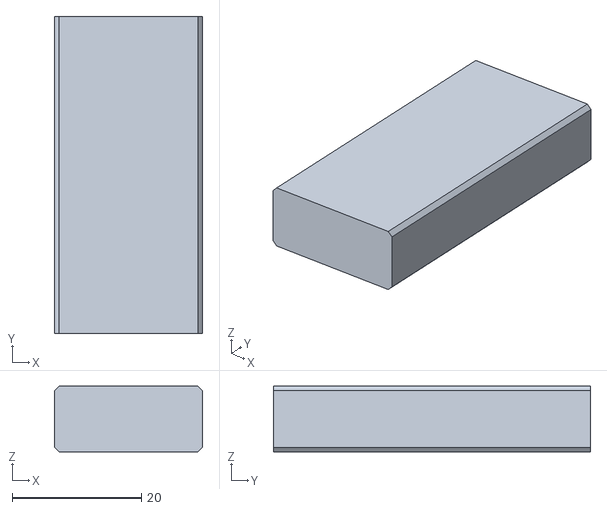
[picture p53: CAD file, 2017-03-29]
models/waveguide-plug/waveguide-plug-R100-L49-XY0-Z0-C1.stl
22.9 x 49.0 x 10.2
