michalprusa/DIP/models/waveguide-plug/waveguide-plug-R100-L20-XY01-Z005-C1.stl

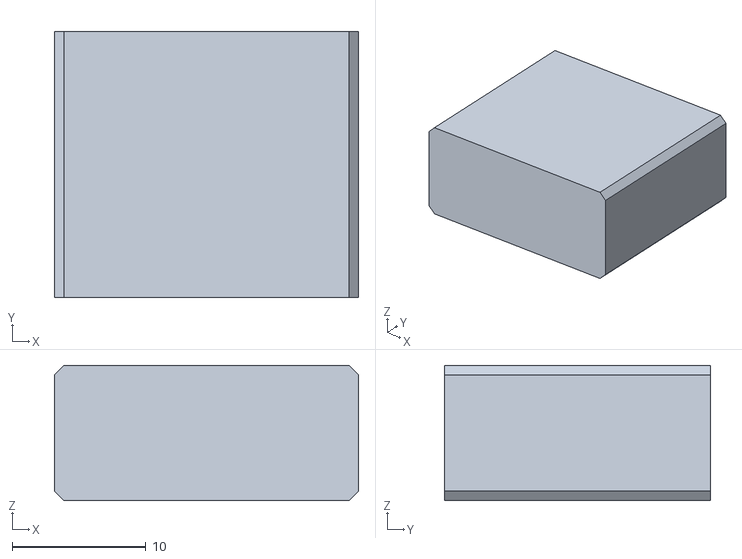
[picture p55: CAD file, 2017-03-22]
models/waveguide-plug/waveguide-plug-R100-L20-XY01-Z005-C1.stl
22.8 x 19.9 x 10.1
