michalprusa/DIP/D/man-data/lens.scad

$fn = 300;
difference(){
rotate_extrude(convexity = 10)
   import (file = "lens.dxf", layer = "lens1");
   
    
    
}
