michalprusa/DIP/(list of files, cad)

Other CAD files:
D/man-data/hornadapter2p.stl
Ant/hrn2part/hornadapterLp.stl
models/waveguide-plug/waveguide-plug-R100-L199-XY0-Z01-C1.stl
models/waveguide-plug/waveguide-plug-R100-L149-XY0-Z01-C1.stl
D/man-data/hornadapter.scad
Ant/Horn 10GHz/ModelCache/Model.psm
Ant/Horn 10GHz/Result/Cache/run000001/Horn 10GHz/ModelCache/Model.psm
Ant/Horn 10GHz/Result/Cache/run000001/Horn 10GHz/Result/Port1_e1.prt
Ant/Horn 10GHz/Result/Cache/run000001/Horn 10GHz/Result/Port1_h1.prt
Ant/Horn 10GHz/Result/Cache/run000002/Horn 10GHz/ModelCache/Model.psm
Ant/Horn 10GHz/Result/Cache/run000002/Horn 10GHz/Result/Port1_e1.prt
Ant/Horn 10GHz/Result/Cache/run000002/Horn 10GHz/Result/Port1_h1.prt
Ant/Horn 10GHz/Result/Cache/run000003/Horn 10GHz/ModelCache/Model.psm
Ant/Horn 10GHz/Result/Cache/run000003/Horn 10GHz/Result/Port1_e1.prt
Ant/Horn 10GHz/Result/Cache/run000003/Horn 10GHz/Result/Port1_h1.prt
Ant/Horn 10GHz/Result/Port1_e1.prt
Ant/Horn 10GHz/Result/Port1_h1.prt
ParamExtract/ParamExtract/Result/Port1_e1.prt
ParamExtract/ParamExtract/Result/Port1_h1.prt
ParamExtract/ParamExtract/Result/Port2_e1.prt
ParamExtract/ParamExtract/Result/Port2_h1.prt
