michalprusa/DIP/models/waveguide-plug/testprint01.png

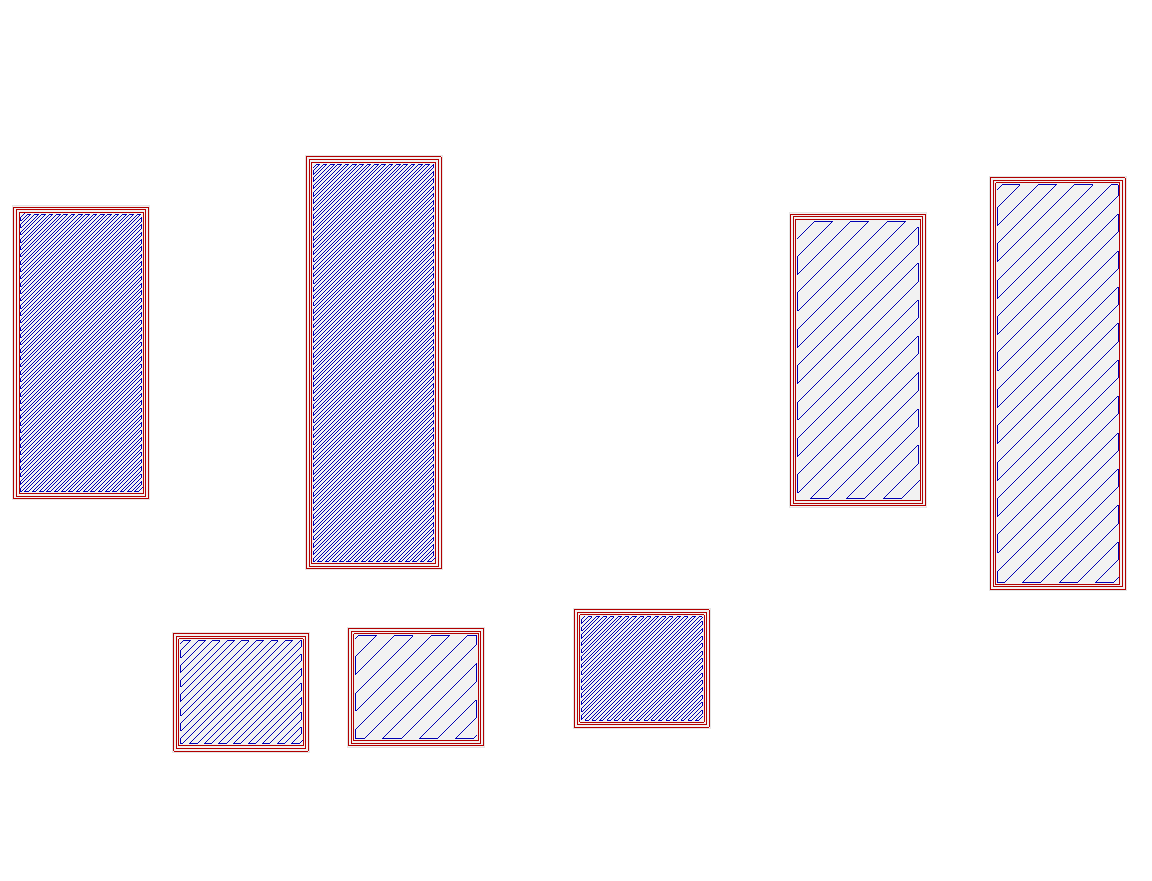
models/waveguide-plug/testprint01.png
