michalprusa/DIP/ParamExtract/Result/EimPLAmlad.png

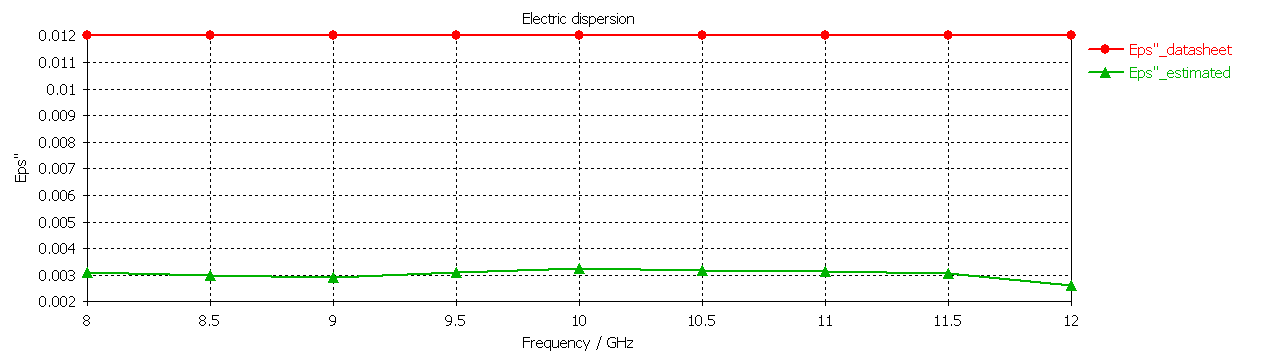
ParamExtract/Result/EimPLAmlad.png
