michalprusa/DIP/ParamExtract/Result/ErePLAmlad.png

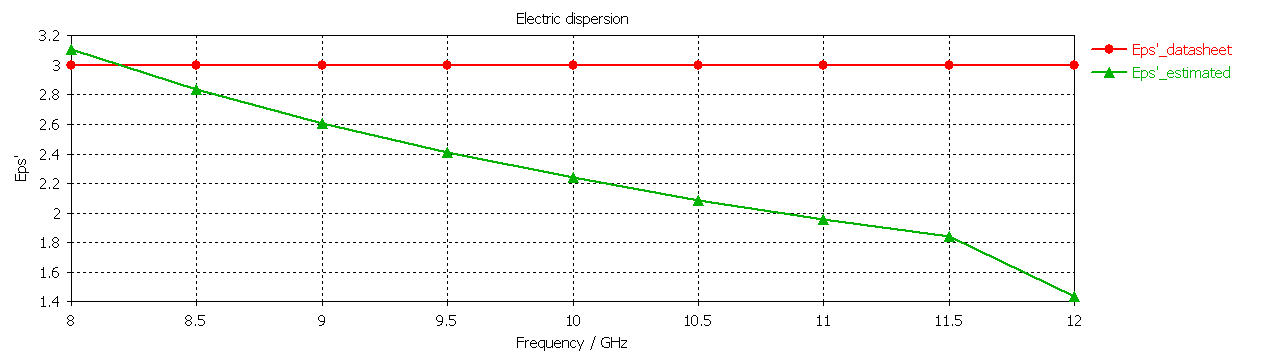
ParamExtract/Result/ErePLAmlad.png
