michalprusa/DIP/ParamExtract/Result/PETmladec/EimPETmlad.png

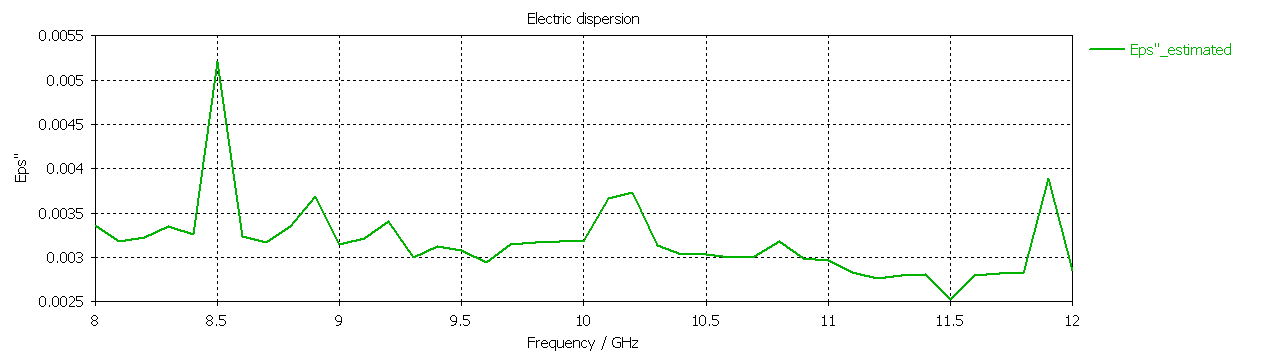
ParamExtract/Result/PETmladec/EimPETmlad.png
