michalprusa/DIP/ParamExtract/Result/PETmladec/ErePETmlad.png

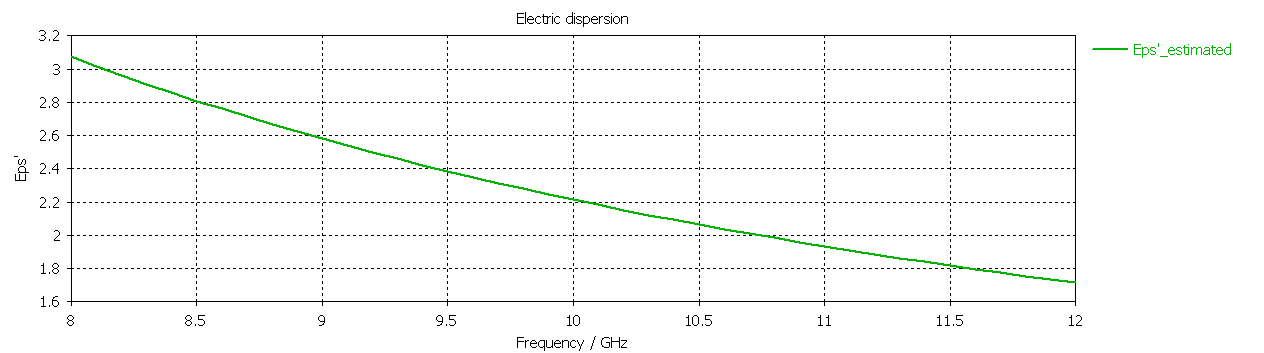
ParamExtract/Result/PETmladec/ErePETmlad.png
