michalprusa/DIP/ParamExtract/Result/PETmladec/tgd_PETmlad.png

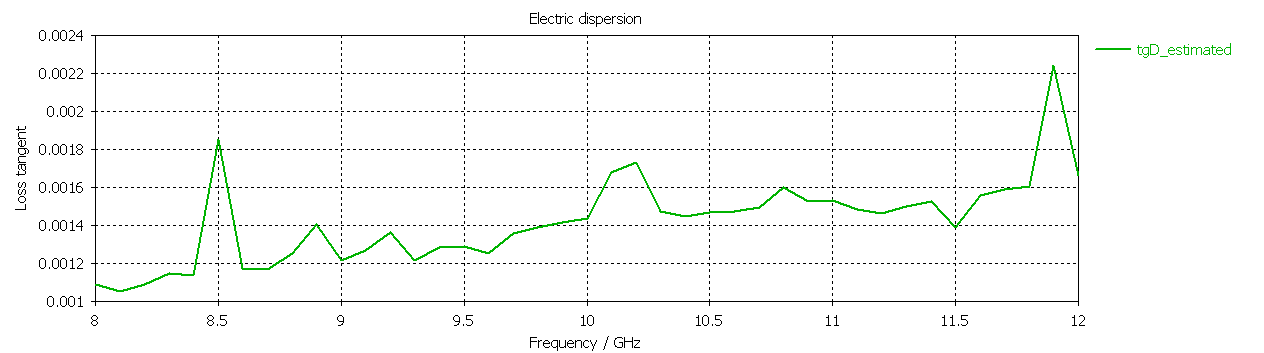
ParamExtract/Result/PETmladec/tgd_PETmlad.png
