michalprusa/DIP/(list of files, drawings)

Other design files:
Ant/Horn 10GHz/Model/3D/Model.dsn
Ant/Horn 10GHz/Result/Cache/run000001/Horn 10GHz/Model/3D/Model.dsn
Ant/Horn 10GHz/Result/Cache/run000002/Horn 10GHz/Model/3D/Model.dsn
Ant/Horn 10GHz/Result/Cache/run000003/Horn 10GHz/Model/3D/Model.dsn
Ant/Horn 10GHz_compare_01/compare_01/Model/3D/Model.dsn
ParamExtract/ParamExtract/Model/3D/Model.dsn
