michalprusa/DIP/(commit log)

2017-03-19 Wavelength calculation for R100,R70,R48
    [WavelengthCalc.xlsx]
2017-03-22 Waveguide plug
    First design and test
    [waveguide-plug-R100-L20-XY01-Z005-C1.stl, waveguide-plug.scad]
2017-03-29 First test batch
    First test batch for material characteristics created and added label
    [waveguide-plug-R100-L20-XY0-Z0-C1.stl, waveguide-plug-R100-L49-XY0-Z0-C1.stl, waveguide-plug-R100-L69-XY0-Z0-C1.stl, waveguide-plug.scad]
2017-04-02 Added label and new models
    Added label for tracking of samples and new models for larger waveguide
    [waveguide-plug-R100-L10-XY0-Z0-C1.stl, waveguide-plug-R100-L149-XY0-Z0-C1.stl, waveguide-plug-R100-L149-XY0-Z01-C1.stl, waveguide-plug-R100-L199-XY0-Z0-C1.stl, waveguide-plug-R100-L199-XY0-Z01-C1.stl, waveguide-plug-R100-L5-XY0-Z0-C1.stl, waveguide-plug.scad]
2017-04-09 Added antenna design and parameter extraction
    [Horn10G-140mm.stl, Model.dsn, Model.psm, Port1_e1.prt, Port1_h1.prt, Port2_e1.prt, Port2_h1.prt, compare_01.xls]
2017-05-10 Added antenna model and lens
    [Horn10G-140mm+adapt.stl, Horn10G-140mm+adapt5.stl, hornadapter.scad, lens.dxf, lens.scad, lens.stl]
2017-05-14 First session added
    [Horn10G-140mm+adapt.stl, hornadapter.scad, hornadapter.stl, hornadapter2p.stl, hornadapterLp.stl, hornadapterRp.stl, hrn.stl]
2017-05-19 Theoretical 3D printing
2017-05-23 Theoretical part probably complete
    [HRN-GRPH-10G.csv, Horn.xlsx, hornik.dxf]
2017-05-25 First pre-RC
    [Horn10G-140mm+adapt.stl, HornSim (version 1).xlsx, HornSim.xlsx, horn.stl, hornadapter.scad]
2017-05-25 Plating added
    [HornSim (version 1).xlsx]
2017-05-26 Pre-final
    Just about there, just finish up theoretical part of horns and comment
    results
    [HornMatch.xlsx, ParamExtract.xlsx]
2017-05-26 Grande finale
    [Horn10G-140mm+adapt5.stl, hornadapter.scad, hornadapter2p.stl, hrn.stl, lens.scad, lens.stl]
